AxtonCTS/Voron-XT0/Firmware/Readme

Printer.cfg is still being tweaked, but should be working
