AxtonCTS/Voron-XT0/STLs/Readme

Print the STLs with Voron standart settings: use ABS, 3 walls, 5 top and bottom layers, 40% infill
