AxtonCTS/Voron-XT0/STLs/Endstop mount-micron.stl

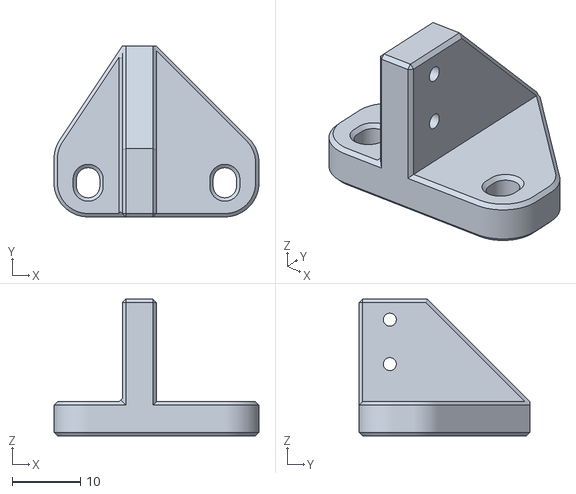
[picture p1: CAD file, 2025-07-20]
STLs/Endstop mount-micron.stl
30.0 x 25.0 x 20.0
