AxtonCTS/Voron-XT0/STLs/Nudge mount.stl

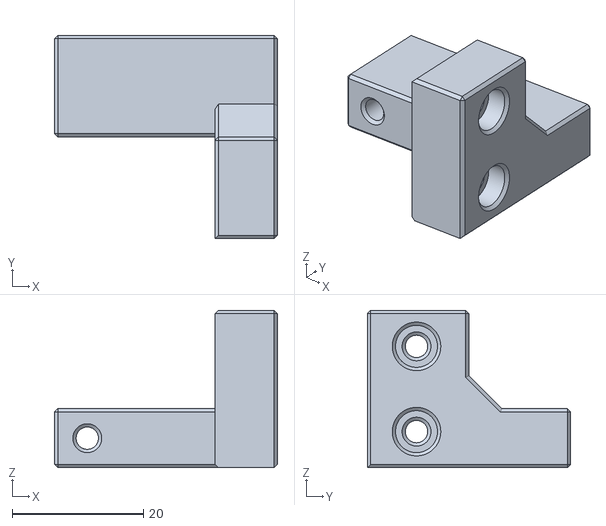
[picture p2: CAD file, 2025-02-02]
STLs/Nudge mount.stl
34.0 x 31.0 x 24.0
