AxtonCTS/Voron-XT0/STLs/Front TFT skirt.stl

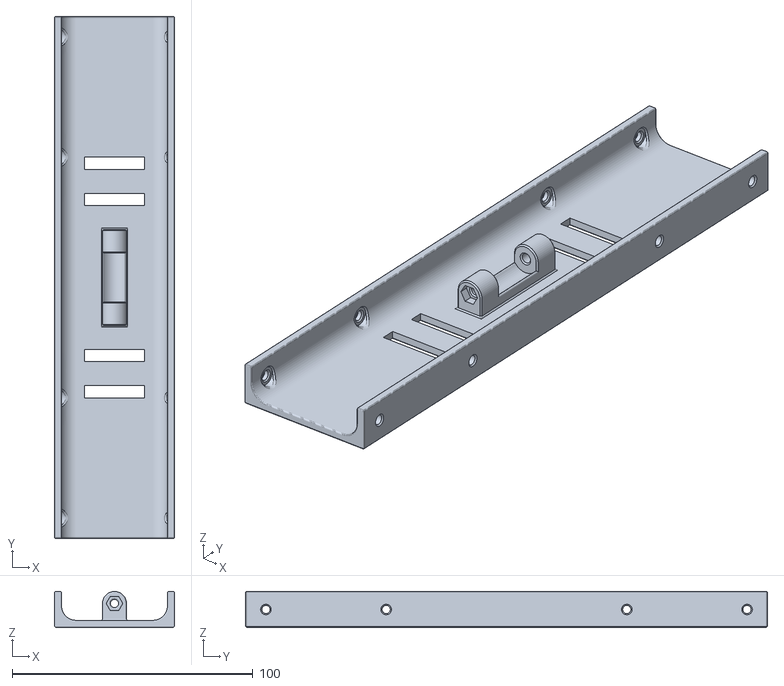
[picture p3: CAD file, 2025-01-28]
STLs/Front TFT skirt.stl
50.0 x 217.0 x 15.0
