AxtonCTS/Voron-XT0/STLs/Front_Bed_Attachment_Plus6mm_Sidehole.stl

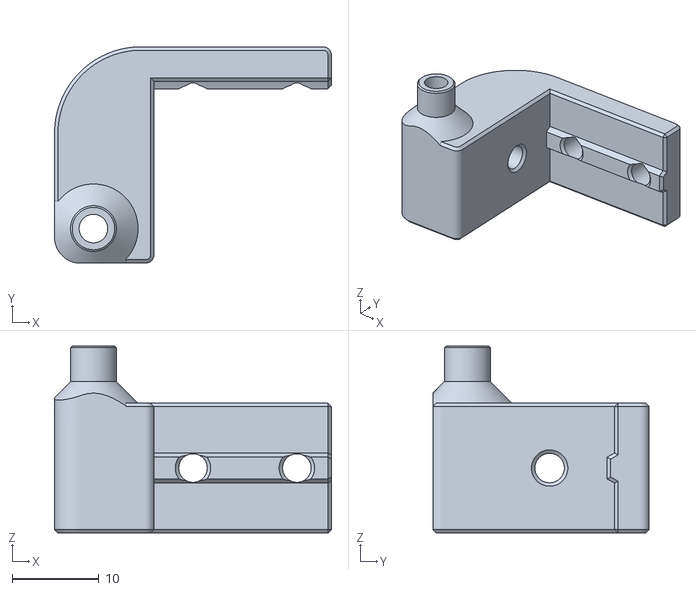
[picture p4: CAD file, 2025-01-28]
STLs/Front_Bed_Attachment_Plus6mm_Sidehole.stl
32.0 x 25.0 x 21.6
