AxtonCTS/Voron-XT0/STLs/TFT lever.stl

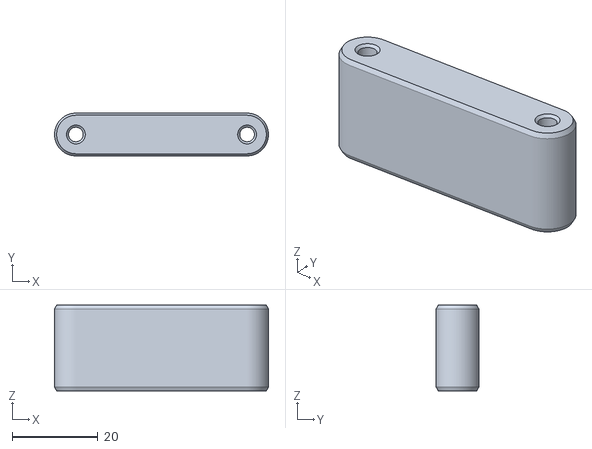
[picture p5: CAD file, 2025-01-28]
STLs/TFT lever.stl
50.0 x 10.0 x 20.0
