AxtonCTS/Voron-XT0/STLs/TFT rear mount.stl

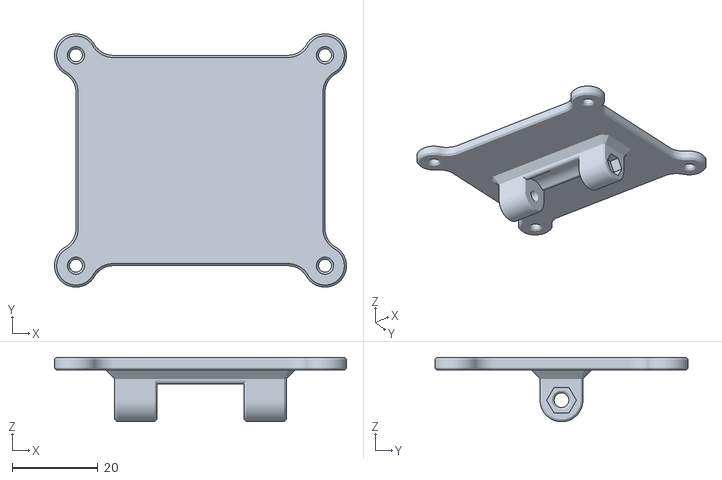
[picture p6: CAD file, 2025-01-28]
STLs/TFT rear mount.stl
68.0 x 59.0 x 15.0
