AxtonCTS/Voron-XT0/Firmware/IDEX_mode.cfg

# This is a file for the IDEX configuration
[respond]

[gcode_macro DC_VARS]
# Offset coordinates for dual_carriage
variable_offset_x: 0 #-0.06  #-0.3 #was -0.15
variable_offset_y: 1.5 #-0.15 #was -0.15 #-0.3 #was0
variable_offset_z: -0.1  # 0.23
# Autopark parameters
## default autopark: 0:inactive - 1:active
variable_autopark: 1
variable_z_hop: 0
variable_movespeed: 300
variable_feedrate: 18000
# HeatBed size
variable_bed_x_min: 0
variable_bed_x_max: 415
# Print cooling fans names
variable_fan0: 'fan_extruder'
variable_fan1: 'fan_extruder1'
# Extruders temp
variable_offset_temp: 0
gcode:

## DUAL-CARRIAGES : FULL_CONTROL - AUTO-PARK

[gcode_macro PARK_extruder]
gcode:
    SAVE_GCODE_STATE NAME=park0
    G90
    G1 X164.5
    RESTORE_GCODE_STATE NAME=park0

# Activate the primary extruder
[gcode_macro T0]
gcode:
    PARK_{printer.toolhead.extruder}
    ACTIVATE_EXTRUDER EXTRUDER=extruder
    SET_DUAL_CARRIAGE CARRIAGE=0
    SET_GCODE_OFFSET Y=0
	
[gcode_macro PARK_extruder1]
gcode:
    SAVE_GCODE_STATE NAME=park1
    G90
    G1 X-37
    RESTORE_GCODE_STATE NAME=park1

[gcode_macro T1]
gcode:
    PARK_{printer.toolhead.extruder}
    ACTIVATE_EXTRUDER EXTRUDER=extruder1
    SET_DUAL_CARRIAGE CARRIAGE=1
    SET_GCODE_OFFSET Y=15

[gcode_macro M605]
description: Set the dual-carriages mode
gcode:
    {% set mode = params.S|default(1)|int %}
    {% set offset_temp = params.R|default(0)|float %}
    {% if printer.dual_carriage is defined %}
        {% if (mode) == 0 %}
            SET_GCODE_VARIABLE MACRO=DC_VARS VARIABLE=autopark VALUE=0
            MODE_FULL_CONTROL
        {% elif (mode) == 1 %}
            SET_GCODE_VARIABLE MACRO=DC_VARS VARIABLE=autopark VALUE=1
            MODE_FULL_CONTROL
        {% elif (mode) == 2 and (params.X) is defined %}
            MODE_DUPLICATION X={params.X} R={offset_temp}
        {% elif (mode) == 2 %}
            MODE_DUPLICATION R={offset_temp}
        {% elif (mode) == 3 %}
            MODE_MIRRORED R={offset_temp}
        {% endif %}
        G1 F3000
    {% endif %}
    
## DUAL-CARRIAGES : PRINT FANS MANAGEMENT

[gcode_macro M106]
description: Override "M106" to allow multiple extruders.
gcode:
    {% set dcvars = printer["gcode_macro DC_VARS"] %}
    {% set raw_speed = params.S|default(0)|float %}
    {% set fan_speed = (raw_speed / 255.0)|round(2) %}
    {% if (params.P) is defined %}
        {% set P_fan = dcvars.fan0 if (params.P)|int == 0 else dcvars.fan1 %}
        SET_FAN_SPEED FAN={P_fan} SPEED={fan_speed}
    {% elif printer.dual_carriage is defined %}
        _SET_PRINT_FANS_SPEED SPEED={fan_speed}
    {% endif %}
    
[gcode_macro M107]
description: Override "M107" to allow multiple extruders.
gcode:
    M106 S0
    
[gcode_macro _SET_PRINT_FANS_SPEED]
gcode:
    {% set dcvars = printer["gcode_macro DC_VARS"] %}
    {% if params.SPEED is defined %}
        {% set fan_speed = params.SPEED|float %}
    {% else %}
        # read print fan speed from active extruder
        {% set fan0_speed = printer["fan_generic " + dcvars.fan0].speed|float %}
        {% set fan1_speed = printer["fan_generic " + dcvars.fan1].speed|float %}
        {% set fan_speed = [fan0_speed, fan1_speed]|max %}
    {% endif %}
    {% if printer.dual_carriage.active_carriage == "BOTH" %}
        SET_FAN_SPEED FAN={dcvars.fan0} SPEED={fan_speed}
        SET_FAN_SPEED FAN={dcvars.fan1} SPEED={fan_speed}
    {% elif printer.dual_carriage.active_carriage == "CARRIAGE_0" %}
        SET_FAN_SPEED FAN={dcvars.fan0} SPEED={fan_speed}
        SET_FAN_SPEED FAN={dcvars.fan1} SPEED={fan_speed}
    {% elif printer.dual_carriage.active_carriage == "CARRIAGE_1" %}
        SET_FAN_SPEED FAN={dcvars.fan0} SPEED={fan_speed}
        SET_FAN_SPEED FAN={dcvars.fan1} SPEED={fan_speed}
    {% endif %}

## DUAL-CARRIAGES : HEATERS MANAGEMENT
    
[gcode_macro M104]
rename_existing: M104.1
description: Override "M104" to allow multiple extruders to be synchronized.
gcode:
    {% set dcvars = printer["gcode_macro DC_VARS"] %}
    {% set temp = params.S|default(0)|float %}
    {% set tool = params.T|default(0)|int %}
    {% if printer.dual_carriage.active_carriage|default() == "BOTH" %}
        {% if tool == 0 %}
            M104.1 T0 S{temp}
            M104.1 T1 S{temp + dcvars.offset_temp|float}
        {% endif %}
    {% else %}
        M104.1 T{tool} S{temp}
    {% endif %}
    
[gcode_macro M109]
rename_existing: M109.1
description: Override "M109" to allow multiple extruders to be synchronized.
gcode:
    {% set dcvars = printer["gcode_macro DC_VARS"] %}
    {% set temp = params.S|default(0)|float %}
    {% set tool = params.T|default(0)|int %}
    {% if printer.dual_carriage.active_carriage|default() == "BOTH" %}
        {% if tool == 0 %}  
            M104.1 T1 S{temp + dcvars.offset_temp|float}
            M109.1 T0 S{temp}
            M109.1 T1 S{temp + dcvars.offset_temp|float}
        {% endif %}
    {% else %}
        M109.1 T{tool} S{temp}
    {% endif %}

[gcode_macro _SYNC_EXTRUDERS_TEMP]
gcode:
    {% set temp = printer["extruder"].target|float %}
    M109 S{temp}
