AxtonCTS/Voron-XT0/Firmware/my_macros.cfg

#####################################
[gcode_macro GET_Z_OFFSET]
gcode:
	T0
	G28 Z
	M400
	GET_POSITION
	T1
	G28 Z
	M400
	GET_POSITION
	

[gcode_macro Z_REPEATABILITY]
gcode:
    # Iterations
	{% set iterations = params.ITERATIONS|default(3)|int %}    
    G28
    {% for i in range(iterations) %}
        G28 Z
        M400 ; wait for moves to finish
		#{action_respond_info("hello")}
		#{action_respond_info("%i" % i)}
		#{% if i != 1 %}
        # 	M117 "second one: {i}"
        #{% else %}
        #    M117 "first iteration"
        #{% endif %}
        GET_POSITION
    {% endfor %}

[gcode_macro IDEX_HOME_Y]
gcode:
    # Home
    G28 Y0
    # Move away
    G1 Y220 F2400

[gcode_macro IDEX_HOME_X]
gcode:
    G28 X0
    ACTIVATE_EXTRUDER EXTRUDER=extruder1
    SET_DUAL_CARRIAGE CARRIAGE=1
    G1 X150 F6000
    T0
