AxtonCTS/Voron-XT0/(commit log)

2025-02-02 Minor changes
    Slightly changed the attach/detach probe macro so the movement grabs the probe better
    X axis endstop location change to accomodate the new bumbers, also changed the toolhead endstop pinout for easier use
    increased the Y axis homing sensitivity. The toolheads stil move a bit after homing, considering moving to adding an endstop on Y axis as well
    [printer.cfg]
2025-02-02 Park location coordinates updated
    This should make it work with the new endstop bumbers
    [IDEX_mode.cfg]
2025-02-02 Added a bed Nudge mount for the bed
    [Nudge mount.stl]
2025-07-20 Update printer.cfg
    Endstop and probe tweaks
    [printer.cfg]
